tm1287/FlightController/Hardware/Documentation/Board.png

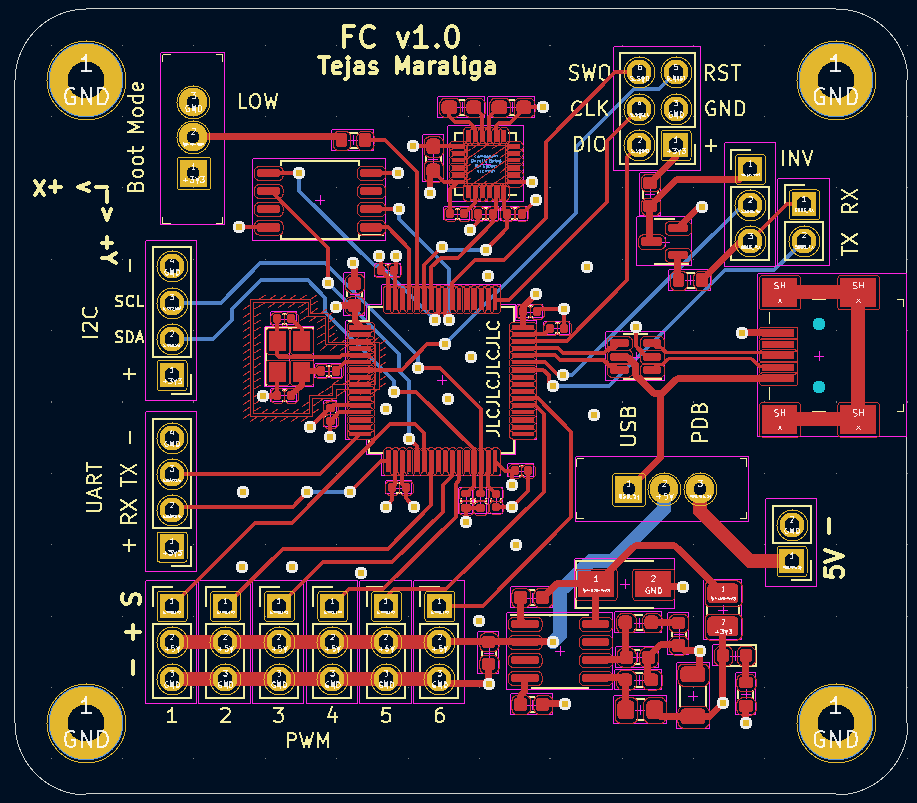
Hardware/Documentation/Board.png
