tm1287/FlightController/Hardware/FlightController/PDB/PDB/Screenshot 2022-06-07 210543.png

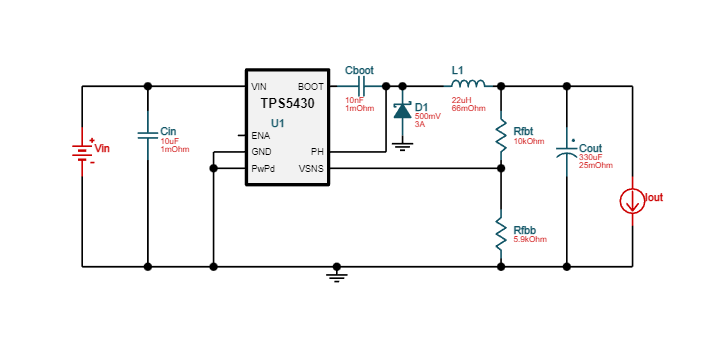
Hardware/FlightController/PDB/PDB/Screenshot 2022-06-07 210543.png
