tm1287/FlightController/Hardware/Documentation/STM32F730R8T6/STM32F730R8T6.step

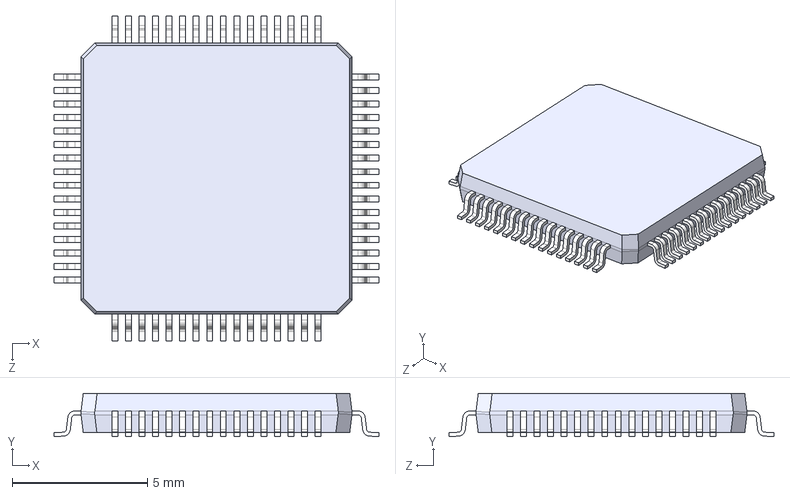
[picture p3: CAD file, 2022-06-09]
Hardware/Documentation/STM32F730R8T6/STM32F730R8T6.step
12.0 x 1.60 x 12.0 mm
