tm1287/FlightController/Hardware/FlightController/FlightController.kicad_pcb

## KiCad design Hardware/FlightController/FlightController.kicad_pcb (2022-07-06)

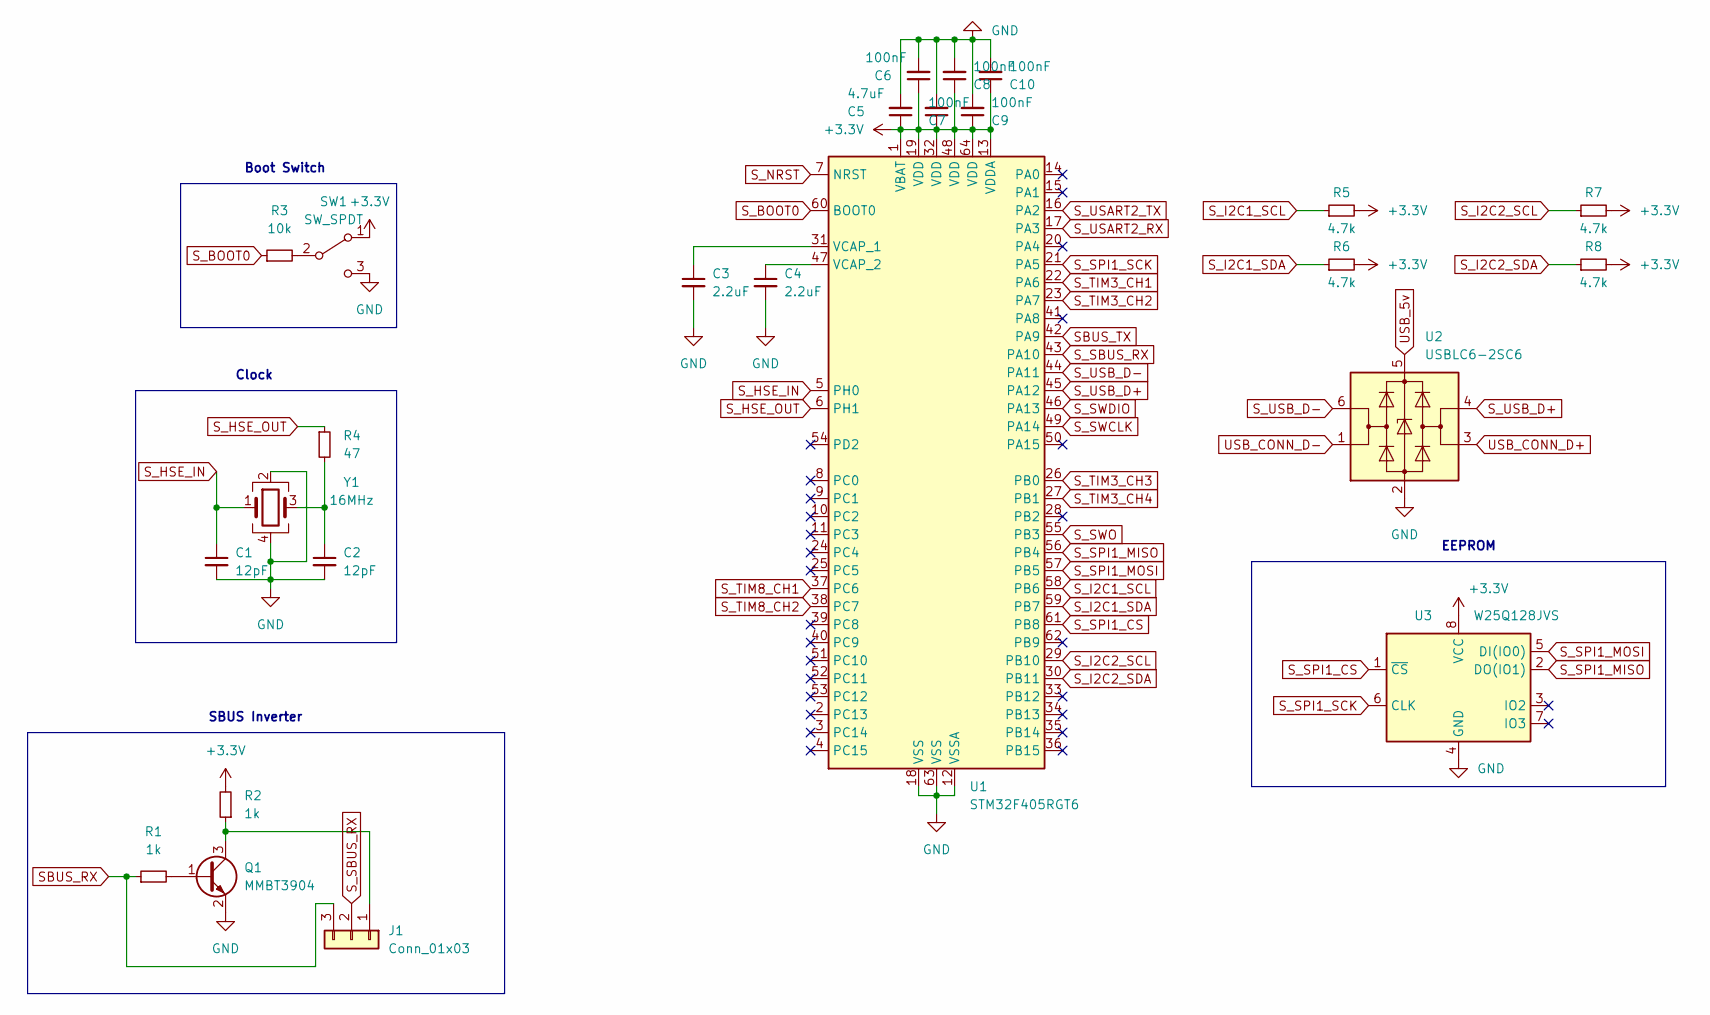
[picture p4: schematic MCU.kicad_sch]

Parts:
C1, C2: 12pF; C_0402_1005Metric; LCSC C1547
C3, C4: 2.2uF; C_0402_1005Metric; LCSC C12530
C5: 4.7uF; C_0603_1608Metric; LCSC C19666
C6, C7, C8, C9, C10: 100nF; C_0402_1005Metric; LCSC C1525
J1: Conn_01x03; PinHeader_1x03_P2.54mm_Vertical
Q1: MMBT3904; SOT-23; LCSC C20526
R1, R2: 1k; R_0603_1608Metric; LCSC C21190
R3: 10k; R_0603_1608Metric; LCSC C25804
R4: 47; R_0402_1005Metric; LCSC C25118
R5, R6, R7, R8: 4.7k; R_0402_1005Metric; LCSC C25900
SW1: SW_SPDT; Switch_Slide_11.6x4mm_EG1218
U1: STM32F405RGT6; LQFP-64_10x10mm_P0.5mm; LCSC C15742
U2: USBLC6-2SC6; SOT-23-6; LCSC C2827654
U3: W25Q128JVS; SOIC-8_5.23x5.23mm_P1.27mm; LCSC C97521
Y1: 16MHz; Crystal_SMD_3225-4Pin_3.2x2.5mm; LCSC C13738

Connections:
+3V3: C5.1, C6.1, C7.1, C8.1, C9.1, C10.1, R2.2, R5.2, R6.2, R7.2, R8.2, SW1.1 (A), U1.1 (VBAT), U1.13 (VDDA), U1.19 (VDD), U1.32 (VDD), U1.48 (VDD), U1.64 (VDD), U3.8 (VCC); also elsewhere on the board
GND: C1.2, C2.2, C3.2, C4.2, C5.2, C6.2, C7.2, C8.2, C9.2, C10.2, Q1.2 (E), SW1.3 (C), U1.12 (VSSA), U1.18 (VSS), U1.63 (VSS), U2.2 (GND), U3.4 (GND), Y1.2, Y1.4; also elsewhere on the board
unnamed: C2.1, R4.2, Y1.3
unnamed: C3.1, U1.31 (VCAP_1)
unnamed: C4.1, U1.47 (VCAP_2)
unnamed: J1.1, Q1.3 (C), R2.1
unnamed: Q1.1 (B), R1.2
unnamed: R3.2, SW1.2 (B)
SBUS_RX: J1.3, R1.1; also elsewhere on the board
SBUS_TX: U1.42 (PA9); also elsewhere on the board
S_BOOT0: R3.1, U1.60 (BOOT0)
S_HSE_IN: C1.1, U1.5 (PH0), Y1.1
S_HSE_OUT: R4.1, U1.6 (PH1)
S_I2C1_SCL: R5.1, U1.58 (PB6); also elsewhere on the board
S_I2C1_SDA: R6.1, U1.59 (PB7); also elsewhere on the board
S_I2C2_SCL: R7.1, U1.29 (PB10); also elsewhere on the board
S_I2C2_SDA: R8.1, U1.30 (PB11); also elsewhere on the board
S_NRST: U1.7 (NRST); also elsewhere on the board
S_SBUS_RX: J1.2, U1.43 (PA10)
S_SPI1_CS: U1.61 (PB8), U3.1 (~CS)
S_SPI1_MISO: U1.56 (PB4), U3.2 (DO(IO1))
S_SPI1_MOSI: U1.57 (PB5), U3.5 (DI(IO0))
S_SPI1_SCK: U1.21 (PA5), U3.6 (CLK)
S_SWCLK: U1.49 (PA14); also elsewhere on the board
S_SWDIO: U1.46 (PA13); also elsewhere on the board
S_SWO: U1.55 (PB3); also elsewhere on the board
S_TIM3_CH1: U1.22 (PA6); also elsewhere on the board
S_TIM3_CH2: U1.23 (PA7); also elsewhere on the board
S_TIM3_CH3: U1.26 (PB0); also elsewhere on the board
S_TIM3_CH4: U1.27 (PB1); also elsewhere on the board
S_TIM8_CH1: U1.37 (PC6); also elsewhere on the board
S_TIM8_CH2: U1.38 (PC7); also elsewhere on the board
S_USART2_RX: U1.17 (PA3); also elsewhere on the board
S_USART2_TX: U1.16 (PA2); also elsewhere on the board
S_USB_D+: U1.45 (PA12), U2.4 (I/O2)
S_USB_D-: U1.44 (PA11), U2.6 (I/O1)
USB_5v: U2.5 (VBUS); also elsewhere on the board
USB_CONN_D+: U2.3 (I/O2); also elsewhere on the board
USB_CONN_D-: U2.1 (I/O1); also elsewhere on the board

Notes on the sheet:
Clock
Boot Switch
SBUS Inverter
EEPROM

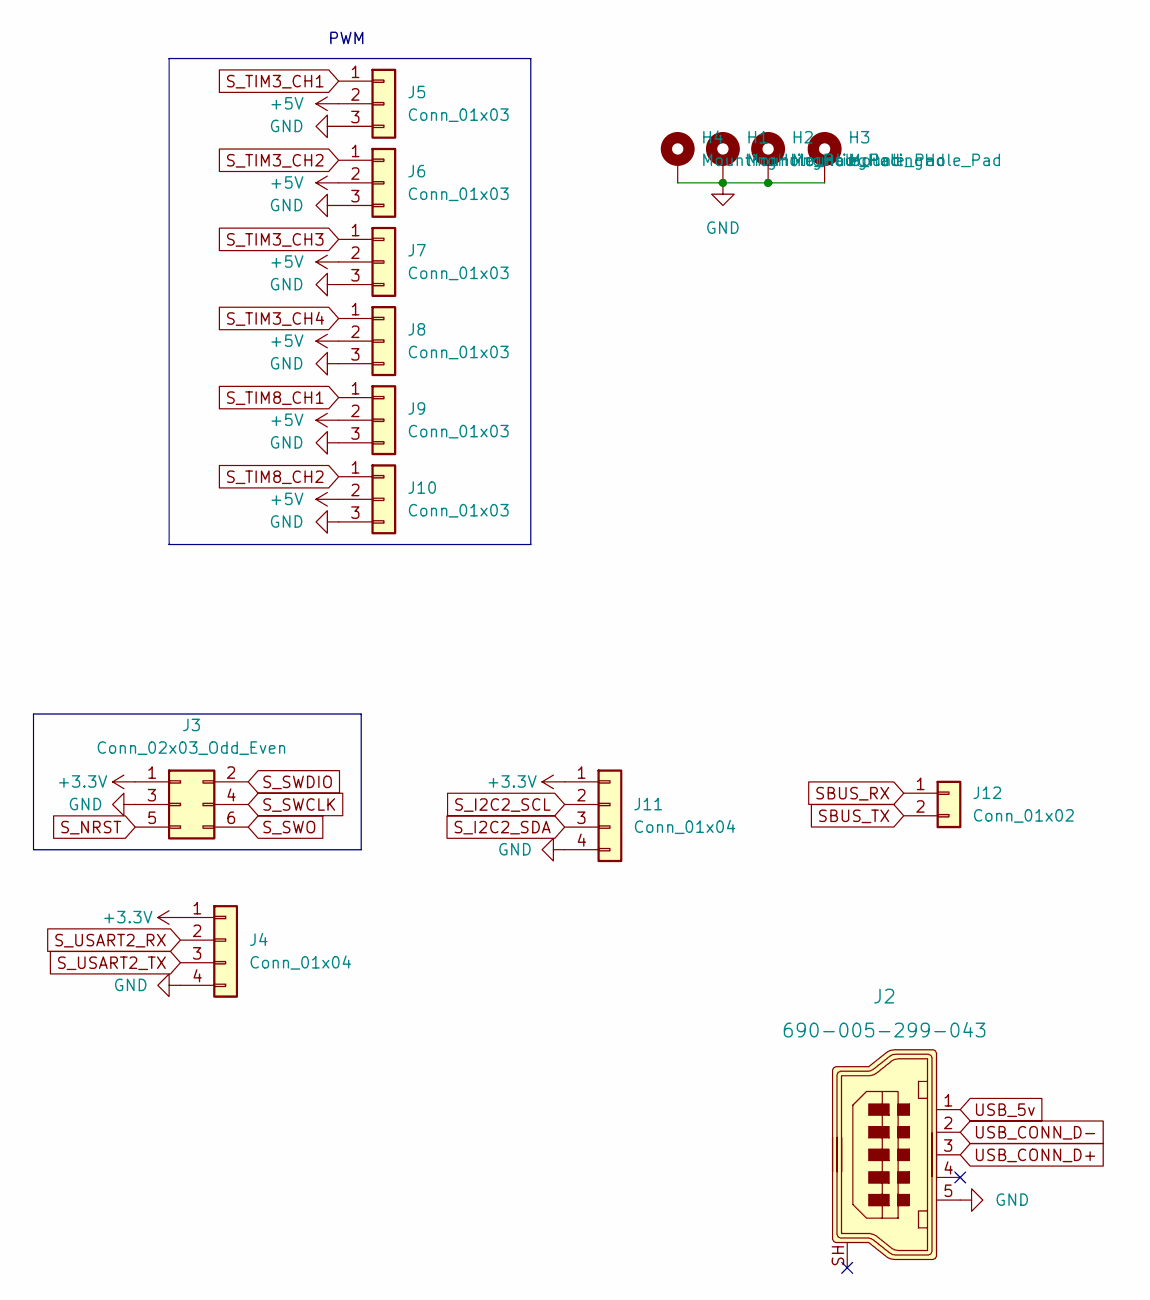
[picture p5: schematic Connectors.kicad_sch]

Parts:
H1, H2, H3, H4: MountingHole_Pad; MountingHole_2.5mm_Pad
J2: 690-005-299-043; USB_Mini_B_Female_690-005-299-043; MPN 690-005-299-043; Digi-Key_PN 151-1206-1-ND
J3: Conn_02x03_Odd_Even; PinHeader_2x03_P2.54mm_Vertical
J4, J11: Conn_01x04; PinHeader_1x04_P2.54mm_Vertical
J5, J6, J7, J8, J9, J10: Conn_01x03; PinHeader_1x03_P2.54mm_Vertical
J12: Conn_01x02; PinHeader_1x02_P2.54mm_Vertical

Connections:
+3V3: J3.1, J4.1, J11.1; also elsewhere on the board
+5V: J5.2, J6.2, J7.2, J8.2, J9.2, J10.2; also elsewhere on the board
GND: H1.1, H2.1, H3.1, H4.1, J2.5, J3.3, J4.4, J5.3, J6.3, J7.3, J8.3, J9.3, J10.3, J11.4; also elsewhere on the board
SBUS_RX: J12.1; also elsewhere on the board
SBUS_TX: J12.2; also elsewhere on the board
S_I2C2_SCL: J11.2; also elsewhere on the board
S_I2C2_SDA: J11.3; also elsewhere on the board
S_NRST: J3.5; also elsewhere on the board
S_SWCLK: J3.4; also elsewhere on the board
S_SWDIO: J3.2; also elsewhere on the board
S_SWO: J3.6; also elsewhere on the board
S_TIM3_CH1: J5.1; also elsewhere on the board
S_TIM3_CH2: J6.1; also elsewhere on the board
S_TIM3_CH3: J7.1; also elsewhere on the board
S_TIM3_CH4: J8.1; also elsewhere on the board
S_TIM8_CH1: J9.1; also elsewhere on the board
S_TIM8_CH2: J10.1; also elsewhere on the board
S_USART2_RX: J4.2; also elsewhere on the board
S_USART2_TX: J4.3; also elsewhere on the board

Notes on the sheet:
PWM

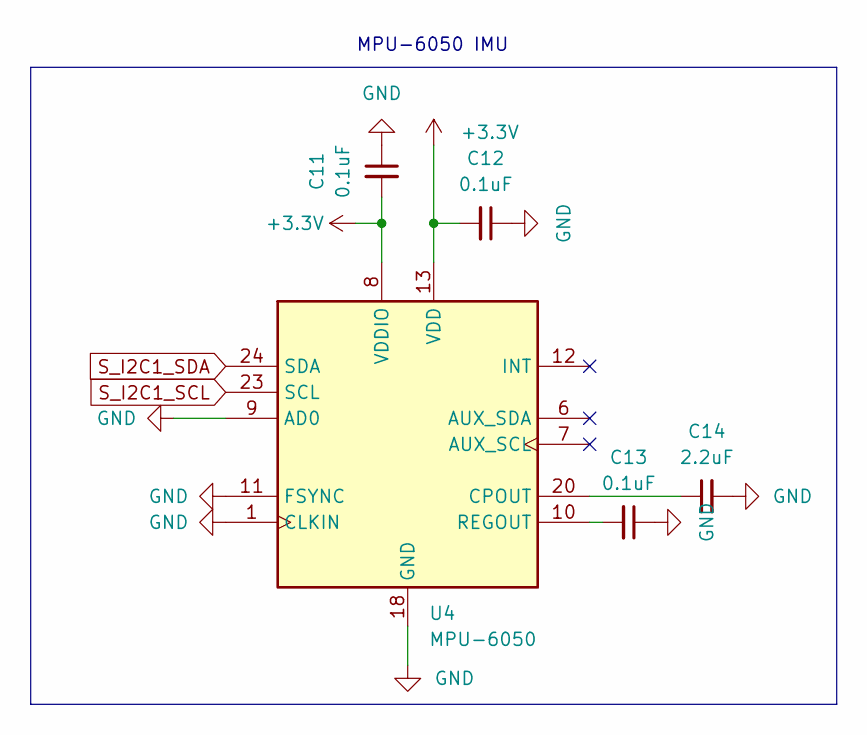
[picture p6: schematic Sensors.kicad_sch]

Parts:
C11, C12, C13: 0.1uF; C_0603_1608Metric_Pad1.08x0.95mm_HandSolder
C14: 2.2uF; C_0402_1005Metric; LCSC C12530
U4: MPU-6050; InvenSense_QFN-24_4x4mm_P0.5mm; LCSC C24112

Connections:
+3V3: C11.2, C12.2, U4.8 (VDDIO), U4.13 (VDD); also elsewhere on the board
GND: C11.1, C12.1, C13.1, C14.2, U4.1 (CLKIN), U4.9 (AD0), U4.11 (FSYNC), U4.18 (GND); also elsewhere on the board
unnamed: C13.2, U4.10 (REGOUT)
unnamed: C14.1, U4.20 (CPOUT)
S_I2C1_SCL: U4.23 (SCL); also elsewhere on the board
S_I2C1_SDA: U4.24 (SDA); also elsewhere on the board

Notes on the sheet:
MPU-6050 IMU

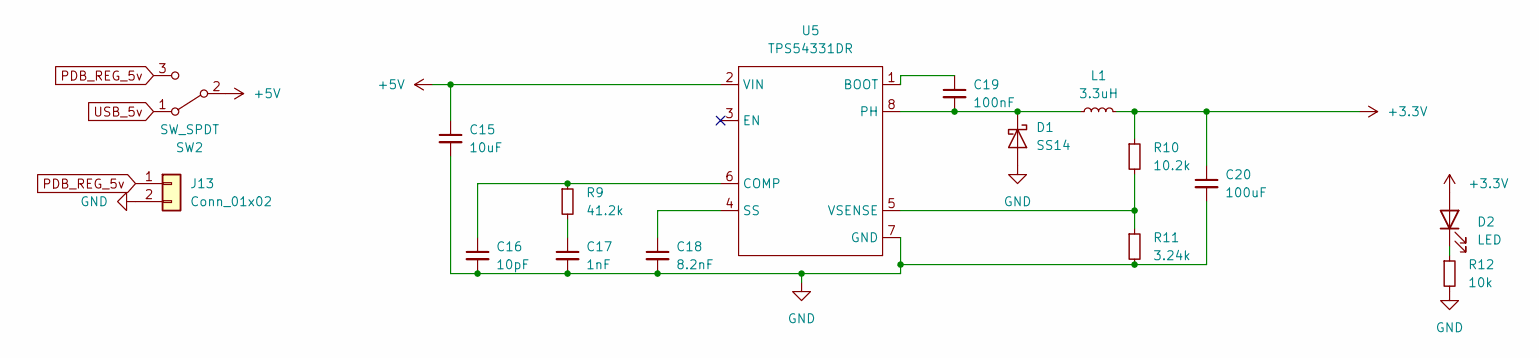
[picture p7: schematic PowerSupply.kicad_sch]

Parts:
C15: 10uF; C_0603_1608Metric; LCSC C96446
C16: 10pF; C_0603_1608Metric; LCSC C1634
C17: 1nF; C_0603_1608Metric; LCSC C1588
C18: 8.2nF; C_0603_1608Metric; LCSC C27920
C19: 100nF; C_0603_1608Metric; LCSC C14663
C20: 100uF; C_1206_3216Metric; LCSC C15008
D1: SS14; D_SMA; LCSC C2480
D2: LED; LED_0603_1608Metric; LCSC C2286
J13: Conn_01x02; PinHeader_1x02_P2.54mm_Vertical
L1: 3.3uH; L_1008_2520Metric_Pad1.43x2.20mm_HandSolder
R9: 41.2k; R_0603_1608Metric_Pad0.98x0.95mm_HandSolder
R10: 10.2k; R_0805_2012Metric_Pad1.20x1.40mm_HandSolder
R11: 3.24k; R_0603_1608Metric_Pad0.98x0.95mm_HandSolder
R12: 10k; R_0603_1608Metric; LCSC C25804
SW2: SW_SPDT; Switch_Slide_11.6x4mm_EG1218
U5: TPS54331DR; SOIC-8_3.9x4.9mm_P1.27mm; LCSC C9865

Connections:
+3V3: C20.1, D2.2 (A), L1.2, R10.1; also elsewhere on the board
+5V: C15.1, SW2.2 (B), U5.2 (VIN); also elsewhere on the board
GND: C15.2, C16.2, C17.2, C18.2, C20.2, D1.2 (A), J13.2, R11.2, R12.2, U5.7 (GND); also elsewhere on the board
unnamed: C16.1, R9.1, U5.6 (COMP)
unnamed: C17.1, R9.2
unnamed: C18.1, U5.4 (SS)
unnamed: C19.1, U5.1 (BOOT)
unnamed: C19.2, D1.1 (K), L1.1, U5.8 (PH)
unnamed: D2.1 (K), R12.1
unnamed: R10.2, R11.1, U5.5 (VSENSE)
PDB_REG_5v: J13.1, SW2.3 (C)
USB_5v: SW2.1 (A); also elsewhere on the board

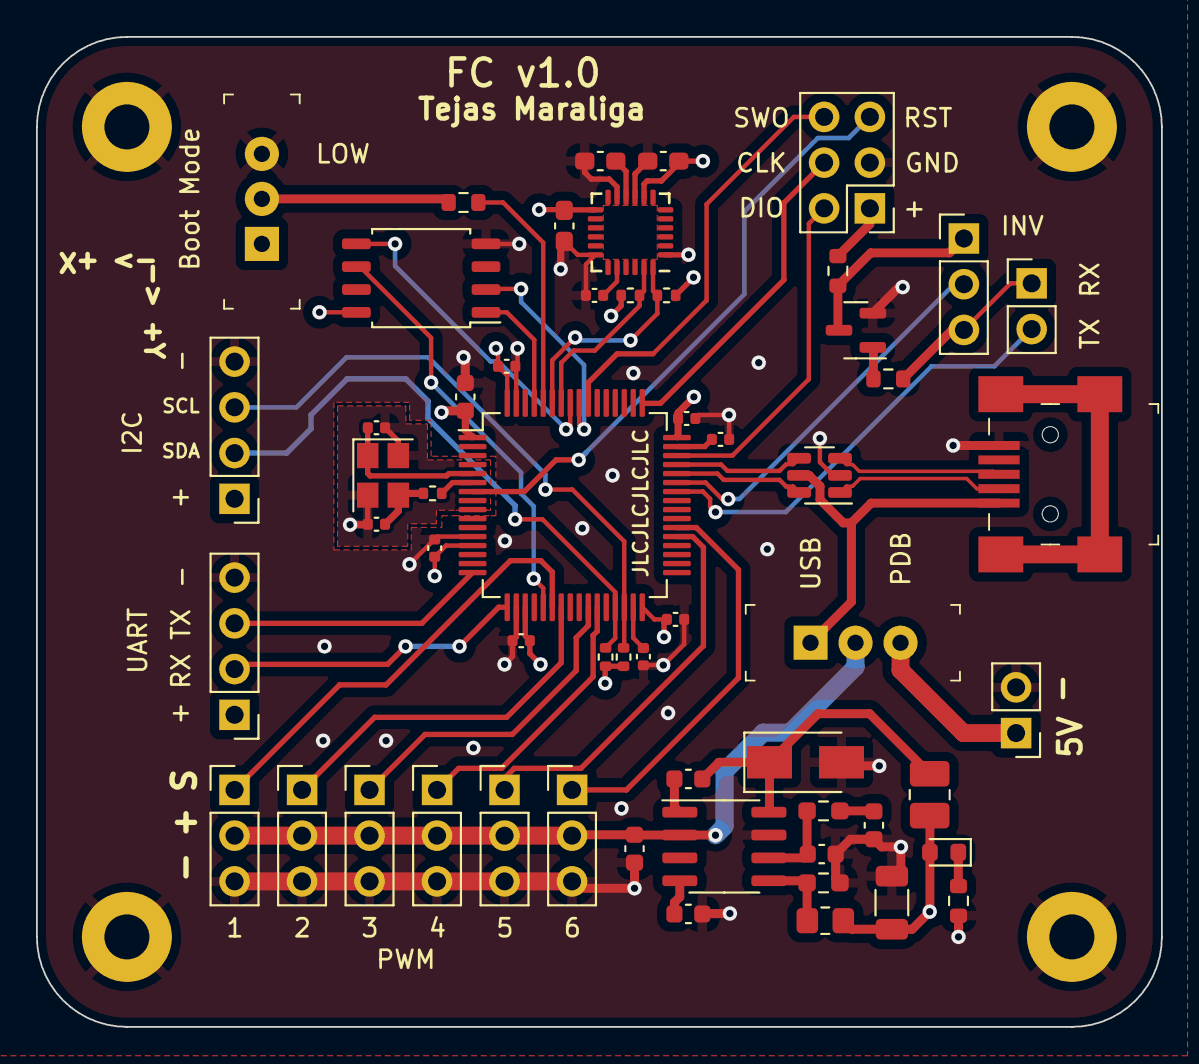
[picture p8: board FlightController.kicad_pcb from above]

Board: 4 copper layers, 62.5 x 55.0 mm, 61 parts (0 on the bottom side), 50 nets.

Other parts of the board:
Je: 690-005-299-043; USB_Mini_B_Female_690-005-299-043

Their connections:
GND: Je.5; also elsewhere on the board
USB_5v: Je.1; also elsewhere on the board
USB_CONN_D+: Je.3; also elsewhere on the board
USB_CONN_D-: Je.2; also elsewhere on the board
