tm1287/FlightController/Hardware/FlightController/PDB/PDB/PDB.kicad_pcb

## KiCad design Hardware/FlightController/PDB/PDB/PDB.kicad_pcb (2022-06-09)

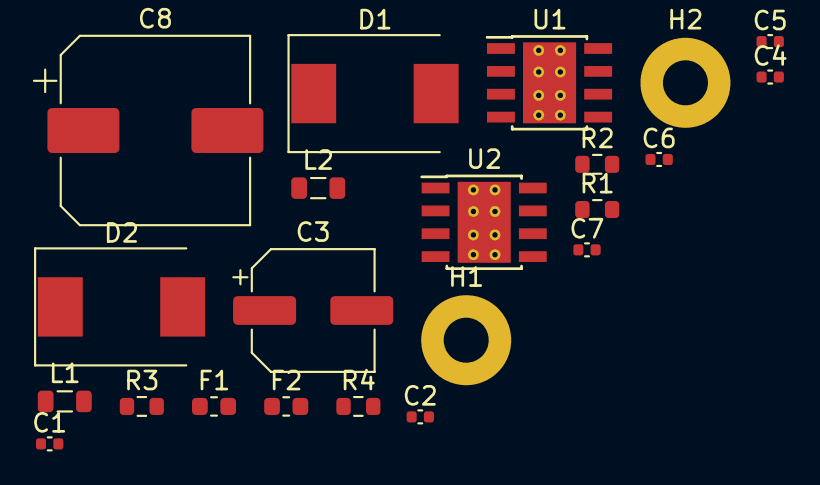
[picture p9: board PDB.kicad_pcb from above]

Board: 2 copper layers, 22 parts (0 on the bottom side), 10 nets, no tracks yet.

Parts:
C1, C2, C4, C5, C6, C7: 10uF; C_0402_1005Metric
C3: 330uF; CP_Elec_6.3x5.8
C8: 220uF; CP_Elec_10x10
D1, D2: B340; D_SMC
F1, F2: 750mA; Fuse_0603_1608Metric
H1, H2: MountingHole_Pad; MountingHole_2.5mm_Pad
L1, L2: 22 uH; L_0805_2012Metric
R1, R3: 10k; R_0603_1608Metric
R2: 5.9k; R_0603_1608Metric
R4: 3.24k; R_0603_1608Metric
U1, U2: TPS5430DDA; TI_SO-PowerPAD-8_ThermalVias

Connections:
+BATT: C1.1, C4.1, C5.1, C6.1, H1.1, U1.7 (VIN), U2.7 (VIN)
GND: C1.2, C3.2, C4.2, C5.2, C6.2, C8.2, D1.2 (A), D2.2 (A), H2.1, R2.2, R4.2, U1.6 (GND), U1.9 (GNDPAD), U2.6 (GND), U2.9 (GNDPAD)
unnamed: C2.1, U1.1 (BOOT)
unnamed: C2.2, D1.1 (K), L1.1, U1.8 (PH)
unnamed: C3.1, F1.1, L1.2, R1.1
unnamed: C7.1, U2.1 (BOOT)
unnamed: C7.2, D2.1 (K), L2.1, U2.8 (PH)
unnamed: C8.1, F2.1, L2.2, R3.1
unnamed: R1.2, R2.1, U1.4 (VSENSE)
unnamed: R3.2, R4.1, U2.4 (VSENSE)
