tm1287/FlightController/SensorControllerFirmware/Core/Src/main.c

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
/* Includes ------------------------------------------------------------------*/
#include "main.h"
#include "usb_device.h"

/* USER CODE BEGIN Includes */
#include "usbd_cdc_if.h"
#include <math.h>
#include "MPU6050.h"
#include "EEPROM.h"
#include "constants.h"
/* USER CODE END Includes */

I2C_HandleTypeDef hi2c1;
I2C_HandleTypeDef hi2c2;

SPI_HandleTypeDef hspi1;

TIM_HandleTypeDef htim3;
TIM_HandleTypeDef htim8;

UART_HandleTypeDef huart1;
UART_HandleTypeDef huart2;

/* USER CODE BEGIN PV */
MPU6050 imu;
EEPROM eeprom;
/* USER CODE END PV */

void SystemClock_Config(void);
static void MX_GPIO_Init(void);
static void MX_I2C1_Init(void);
static void MX_USART2_UART_Init(void);
static void MX_I2C2_Init(void);
static void MX_USART1_UART_Init(void);
static void MX_TIM3_Init(void);
static void MX_TIM8_Init(void);
static void MX_SPI1_Init(void);
/**
  * @brief  The application entry point.
  * @retval int
  */
int main(void)
{
  /* MCU Configuration--------------------------------------------------------*/

  /* Reset of all peripherals, Initializes the Flash interface and the Systick. */
  HAL_Init();

  /* Configure the system clock */
  SystemClock_Config();

  /* Initialize all configured peripherals */
  MX_GPIO_Init();
  MX_I2C1_Init();
  MX_USART2_UART_Init();
  MX_USB_DEVICE_Init();
  MX_I2C2_Init();
  MX_USART1_UART_Init();
  MX_TIM3_Init();
  MX_TIM8_Init();
  MX_SPI1_Init();
  /* Infinite loop */
  /* USER CODE BEGIN WHILE */
  MPU6050_Initialize(&imu, &hi2c1);
  EEPROM_Initialize(&eeprom, &hspi1);
  //EEPROM_ReadId(&eeprom, &j_id);
  /*
  HAL_GPIO_WritePin(CS_PORT, CS_PIN, GPIO_PIN_RESET);
  uint8_t id_reg = 0x90;
  uint8_t ret;
  uint32_t Temp = 0, Temp0 = 0, Temp1 = 0, Temp2 = 0;
  HAL_SPI_TransmitReceive(&hspi1, &id_reg, &ret, 1, 100);
  uint32_t dummy_data = 0xA5;
  HAL_SPI_TransmitReceive(&hspi1, &dummy_data, &Temp0, 1, 100);
  HAL_SPI_TransmitReceive(&hspi1, &dummy_data, &Temp1, 1, 100);
  HAL_SPI_TransmitReceive(&hspi1, &dummy_data, &Temp2, 1, 100);
  HAL_GPIO_WritePin(CS_PORT, CS_PIN, GPIO_PIN_SET);

  Temp = (Temp0 << 16) | (Temp1 << 8) | Temp2;
  */
  uint8_t logBuf[32];
  uint8_t bufLen;

  double phiHat_acc_rad = 0.0f;
  double thetaHat_acc_rad = 0.0f;
  double phiDot_rps = 0.0f;
  double thetaDot_rps = 0.0f;
  double phiHat_rad = 0.0f;
  double thetaHat_rad = 0.0f;

  while (1)
  {
    /* USER CODE END WHILE */

    /* USER CODE BEGIN 3 */

	MPU6050_ReadAccel(&imu);
	MPU6050_ReadGyro(&imu);

	phiHat_acc_rad = atanf(imu.acc_mps2[1] / imu.acc_mps2[2]);
	thetaHat_acc_rad = asinf(imu.acc_mps2[0] / G_MS2);


	phiDot_rps = imu.gyr_rps[0] + (tanf(thetaHat_rad) * sinf(phiHat_rad) * imu.gyr_rps[1]) + (tanf(thetaHat_rad) * cosf(phiHat_rad) * imu.gyr_rps[2]);
	thetaDot_rps = cosf(phiHat_rad) * imu.gyr_rps[1] - sinf(phiHat_rad) * imu.gyr_rps[2];

	phiHat_rad = CF_ALPHA * phiHat_acc_rad + (1.0f - CF_ALPHA) * (phiHat_rad + (20 / 1000.0f) * phiDot_rps);
	thetaHat_rad = CF_ALPHA * thetaHat_acc_rad + (1.0f - CF_ALPHA) * (thetaHat_rad + (20 / 1000.0f) * thetaDot_rps);

	bufLen = snprintf(logBuf, 32, "%.3f,%.3f\r\n", phiHat_rad * RAD_TO_DEG, thetaHat_rad * RAD_TO_DEG);
	//bufLen = snprintf(logBuf, 32, "%.3f,%.3f,%.3f\r\n", p, q, r);

	CDC_Transmit_FS((uint8_t *) logBuf, bufLen);


	HAL_Delay(20);
  }
  /* USER CODE END 3 */
}

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
