tm1287/FlightController/SensorControllerFirmware/SensorControllerFirmware.ioc

Mcu.UserName=STM32F405RGTx
PA10.Signal=USART1_RX
PA11.Signal=USB_OTG_FS_DM
PA12.Signal=USB_OTG_FS_DP
PA13.Signal=SYS_JTMS-SWDIO
PA14.Signal=SYS_JTCK-SWCLK
PA2.Signal=USART2_TX
PA3.Signal=USART2_RX
PA5.Signal=SPI1_SCK
PA6.Signal=S_TIM3_CH1
PA7.Signal=S_TIM3_CH2
PA9.Signal=USART1_TX
PB0.Signal=S_TIM3_CH3
PB1.Signal=S_TIM3_CH4
PB10.Signal=I2C2_SCL
PB11.Signal=I2C2_SDA
PB3.Signal=SYS_JTDO-SWO
PB4.Signal=SPI1_MISO
PB5.Signal=SPI1_MOSI
PB6.Signal=I2C1_SCL
PB7.Signal=I2C1_SDA
PB8.GPIO_Label=EEPROM_CS
PB8.Signal=GPIO_Output
PC6.Signal=S_TIM8_CH1
PC7.Signal=S_TIM8_CH2
PH0-OSC_IN.Signal=RCC_OSC_IN
PH1-OSC_OUT.Signal=RCC_OSC_OUT
