tm1287/FlightController/SensorControllerFirmware/Core/Inc/constants.h

/*
 * constants.h
 *
 *  Created on: Jul 7, 2022
 *      Author: Tejas
 */

#ifndef INC_CONSTANTS_H_
#define INC_CONSTANTS_H_

#define RAD_TO_DEG	57.2957795131f
#define G_MS2	9.8100000000f
#define CF_ALPHA 0.0250000000f

#endif /* INC_CONSTANTS_H_ */
