tm1287/FlightController/(commit log)

2022-05-31 Add Sensor MCU schematic items
    [ComputerConnection.kicad_sch, Display.kicad_sch, FlightComputer.kicad_sch, FlightConnectors.kicad_sch, FlightController.kicad_pcb, FlightController.kicad_sch, FlightEEPROM.kicad_sch, PowerSupply.kicad_sch]
2022-05-31 Add ICM-42670-P symbol and schematic
    [FlightComputer.kicad_sch, FlightController.kicad_pcb, FlightController.kicad_sch, PowerSupply.kicad_sch, SensorComputer.kicad_sch, Sensors.kicad_sch]
2022-06-09 Round out basic schematic and add preliminary board layout
    [ComputerConnection.kicad_sch, Connectors.kicad_sch, Display.kicad_sch, FlightComputer.kicad_sch, FlightConnectors.kicad_sch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]
2022-06-13 Add and route SBUS inverter
    [FlightController.kicad_pcb, FlightController.kicad_sch, MCU.kicad_sch, PowerSupply.kicad_sch, Sensors.kicad_sch]
2022-06-15 Update footprints to be digikey compliant
    [Connectors.kicad_sch, FlightController.kicad_pcb, FlightController.kicad_sch, MCU.kicad_sch, PowerSupply.kicad_sch, Sensors.kicad_sch]
2022-06-16 Update footprints, routing and LCSC numbers
    [Connectors.kicad_sch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]
2022-06-21 Finalize design and routing for v1.0 fab
    [Connectors.kicad_sch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]
2022-06-21 Generate code for STM32CubeIDE
2022-07-06 Add simple I2C and USB testing code
2022-07-06 Read and stream acceleration values from MPU6050
    [FlightController.kicad_pcb]
2022-07-06 Calculate basic pitch and roll through acceleration values.
2022-07-07 Move IMU initialization and polling into functions
2022-07-07 Add complementary filter for estimating pitch and roll
2022-07-07 Abstract MPU6050 functions into driver interface
    [LoggedData.csv, LoggedData1.csv]
2022-07-07 Update clock speed and timer prescalers
2022-07-11 Incomplete EEPROM driver
    [LoggedData_NaN.csv]
