tm1287/FlightController/(notices)

Notices in the files:
SensorControllerFirmware/Core/Src/main.c:
Copyright (c) 2022 STMicroelectronics.
All rights reserved.
This software is licensed under terms that can be found in the LICENSE file
